ararobo/GN10RemoteEmergencyStop/docs/PowerCutoffBoard_parts.md

# PowerCutoffBoard's parts list
This list is memo.

## K
|KiCad|Name|URL|
|:-:|:-:|:-:|
|K1|FBR562ND12-W|https://docs.rs-online.com/b128/A700000006723828.pdf|

## D
|KiCad|Name|URL|
|:-:|:-:|:-:|
|D3,D4|

## Y
|KiCad|Name|URL|
|:-:|:-:|:-:|
|Y1|CSTNE24M0VH3C000R0|https://www.mouser.jp/ProductDetail/Murata-Electronics/CSTNE24M0VH3C000R0?qs=hd1VzrDQEGgTlQsO5HCwUg%3D%3D|

## Q
|KiCad|Name|URL|
|:-:|:-:|:-:|
|Q1,Q2|SSM3K341R|https://www.mouser.jp/ProductDetail/Toshiba/SSM3K341RLF?qs=PDgMCp4xDJYlECuIdOFceQ%3D%3D|

## U
|KiCad|Name|URL|
|:-:|:-:|:-:|
|U1|STM32G431CBU3|https://www.mouser.jp/ProductDetail/STMicroelectronics/STM32G431CBU3?qs=PzGy0jfpSMuhNWEWgwfZ0w%3D%3D|
|U1|STM32G431CBU6|https://www.mouser.jp/ProductDetail/STMicroelectronics/STM32G431CBU6?qs=T3oQrply3y%252B0hTuSHQ7oqA%3D%3D|
|U2|MIC4427ZM|https://www.mouser.jp/ProductDetail/Microchip-Technology/MIC4427ZM-TR?qs=U6T8BxXiZAXGJd0nLDru8w%3D%3D|
|U3|MCP2562-E/SN|https://www.mouser.jp/ProductDetail/Microchip-Technology/MCP2562-E-SN?qs=6qKXPk0vzx3LlPUMCCw%252BCg%3D%3D|
|U4|Wio-E5|https://www.mouser.jp/ProductDetail/Seeed-Studio/317990687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|
|U5|OSL10326-IR|https://akizukidenshi.com/catalog/g/g112644/|
|U6|TPS1117LV33S|https://akizukidenshi.com/catalog/g/g117229/|

## C
|KiCad|Name|URL|
|:-:|:-:|:-:|
|C19,C20|dia:18, lead:7.5|https://www.mouser.jp/ProductDetail/Nichicon/UHE1H272MHD?qs=MKCO98gu%252BEEMRtwCCrkFNQ%3D%3D|
