ararobo/GN10RemoteEmergencyStop/hardware/PowerCutoffBoard1/PowerCutoffBoard1.kicad_pcb

## KiCad design hardware/PowerCutoffBoard1/PowerCutoffBoard1.kicad_pcb (2025-09-01)

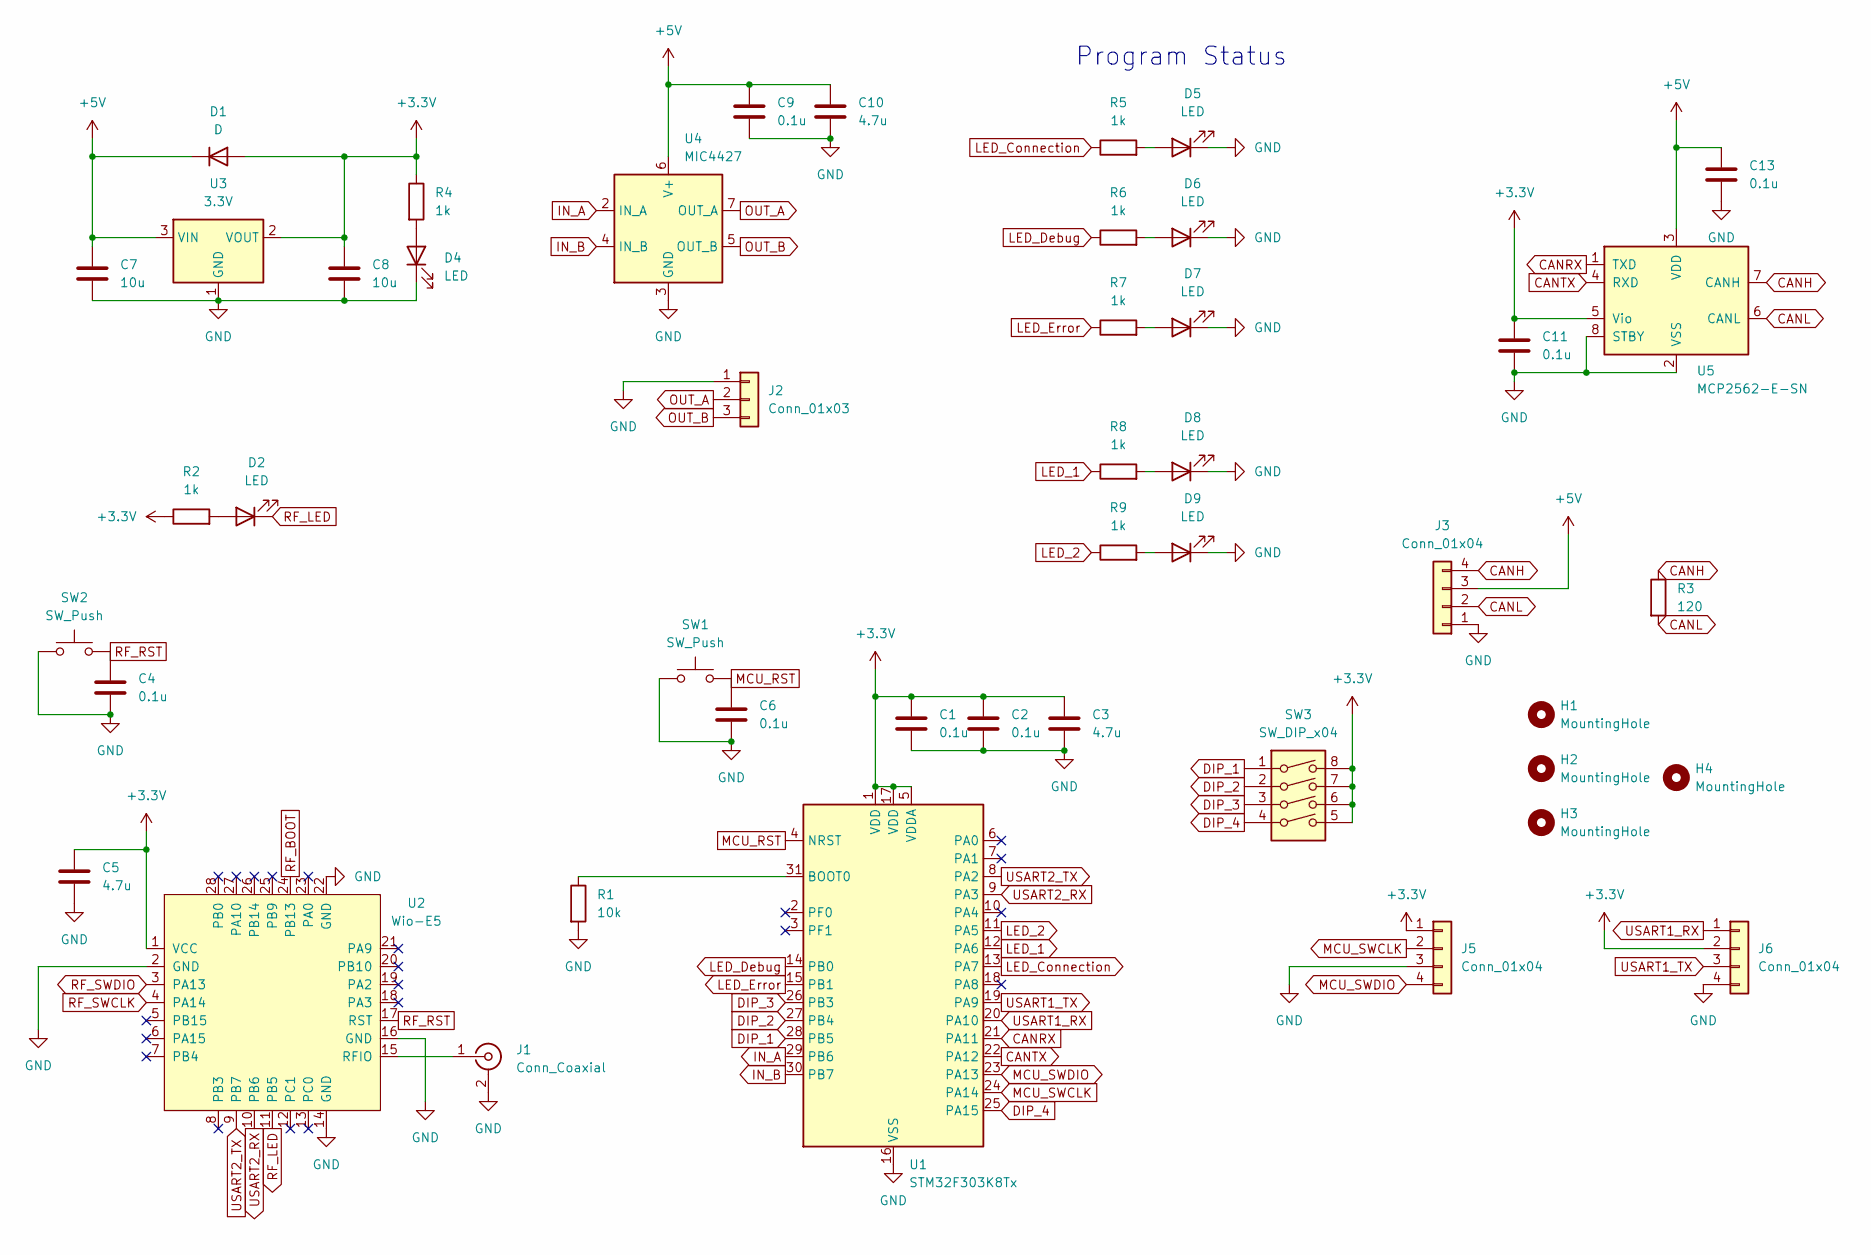
[picture p2: schematic PowerCutoffBoard1.kicad_sch]

Parts:
C1, C2, C4, C6, C9, C11, C13: 0.1u; C_0603_1608Metric_Pad1.08x0.95mm_HandSolder
C3, C5, C10: 4.7u; C_0603_1608Metric_Pad1.08x0.95mm_HandSolder
C7, C8: 10u; C_0603_1608Metric_Pad1.08x0.95mm_HandSolder
D1: D; Nexperia_CFP3_SOD-123W
D2, D4, D5, D6, D7, D8, D9: LED; LED_0603_1608Metric_Pad1.05x0.95mm_HandSolder
H1, H2, H3, H4: MountingHole; MountingHole_3.2mm_M3
J1: Conn_Coaxial; SMA_Molex_73251-2120_EdgeMount_Horizontal
J2: Conn_01x03; AMASS_MR30PW-FB_1x03_P3.50mm_Horizontal
J3: Conn_01x04; JST_XH_S4B-XH-A_1x04_P2.50mm_Horizontal
J5, J6: Conn_01x04; JST_XH_B4B-XH-A_1x04_P2.50mm_Vertical
R1: 10k; C_0603_1608Metric_Pad1.08x0.95mm_HandSolder
R2, R4, R5, R6, R7, R8, R9: 1k; C_0603_1608Metric_Pad1.08x0.95mm_HandSolder
R3: 120; R_0603_1608Metric_Pad0.98x0.95mm_HandSolder
SW1, SW2: SW_Push; TVAF
SW3: SW_DIP_x04; SW_DIP_SPSTx04_Slide_Copal_CHS-04B_W7.62mm_P1.27mm
U1: STM32F303K8Tx; LQFP-32_7x7mm_P0.8mm
U2: Wio-E5; LoRa-E5
U3: 3.3V; SOT-223-3_TabPin2
U4: MIC4427; SOIC-8_3.9x4.9mm_P1.27mm
U5: MCP2562-E-SN; SOIC-8_3.9x4.9mm_P1.27mm

Connections:
+3.3V: C1.1, C2.1, C3.1, C5.1, C8.1, C11.1, D1.2 (A), J5.1, J6.2, R2.1, R4.1, SW3.5, SW3.6, SW3.7, SW3.8, U1.1 (VDD), U1.5 (VDDA), U1.17 (VDD), U2.1 (VCC), U3.2 (VOUT), U5.5 (Vio)
+5V: C7.1, C9.1, C10.1, C13.1, D1.1 (K), J3.3, U3.3 (VIN), U4.6 (V+), U5.3 (VDD)
CANH: J3.4, R3.1, U5.7 (CANH)
CANL: J3.2, R3.2, U5.6 (CANL)
CANRX: U1.21 (PA11), U5.1 (TXD)
CANTX: U1.22 (PA12), U5.4 (RXD)
DIP_1: SW3.1, U1.28 (PB5)
DIP_2: SW3.2, U1.27 (PB4)
DIP_3: SW3.3, U1.26 (PB3)
DIP_4: SW3.4, U1.25 (PA15)
GND: C1.2, C2.2, C3.2, C4.2, C5.2, C6.2, C7.2, C8.2, C9.2, C10.2, C11.2, C13.2, D4.1 (K), D5.1 (K), D6.1 (K), D7.1 (K), D8.1 (K), D9.1 (K), J1.2 (Ext), J2.1, J3.1, J5.3, J6.4, R1.2, SW1.1, SW2.1, U1.16 (VSS), U1.32 (VSS), U2.2 (GND), U2.14 (GND), U2.16 (GND), U2.22 (GND), U3.1 (GND), U4.3 (GND), U5.2 (VSS), U5.8 (STBY)
IN_A: U1.29 (PB6), U4.2 (IN_A)
IN_B: U1.30 (PB7), U4.4 (IN_B)
LED_1: R8.1, U1.12 (PA6)
LED_2: R9.1, U1.11 (PA5)
LED_Connection: R5.1, U1.13 (PA7)
LED_Debug: R6.1, U1.14 (PB0)
LED_Error: R7.1, U1.15 (PB1)
MCU_RST: C6.1, SW1.2, U1.4 (NRST)
MCU_SWCLK: J5.2, U1.24 (PA14)
MCU_SWDIO: J5.4, U1.23 (PA13)
unnamed: D2.2 (A), R2.2
unnamed: D4.2 (A), R4.2
unnamed: D5.2 (A), R5.2
unnamed: D6.2 (A), R6.2
unnamed: D7.2 (A), R7.2
unnamed: D8.2 (A), R8.2
unnamed: D9.2 (A), R9.2
unnamed: J1.1 (In), U2.15 (RFIO)
unnamed: R1.1, U1.31 (BOOT0)
OUT_A: J2.2, U4.7 (OUT_A)
OUT_B: J2.3, U4.5 (OUT_B)
RF_BOOT: U2.24 (PB13~)
RF_LED: D2.1 (K), U2.11 (PB5)
RF_RST: C4.1, SW2.2, U2.17 (RST)
RF_SWCLK: U2.4 (PA14)
RF_SWDIO: U2.3 (PA13)
USART1_RX: J6.1, U1.20 (PA10)
USART1_TX: J6.3, U1.19 (PA9)
USART2_RX: U1.9 (PA3), U2.10 (PB6)
USART2_TX: U1.8 (PA2), U2.9 (PB7)

Notes on the sheet:
Program Status

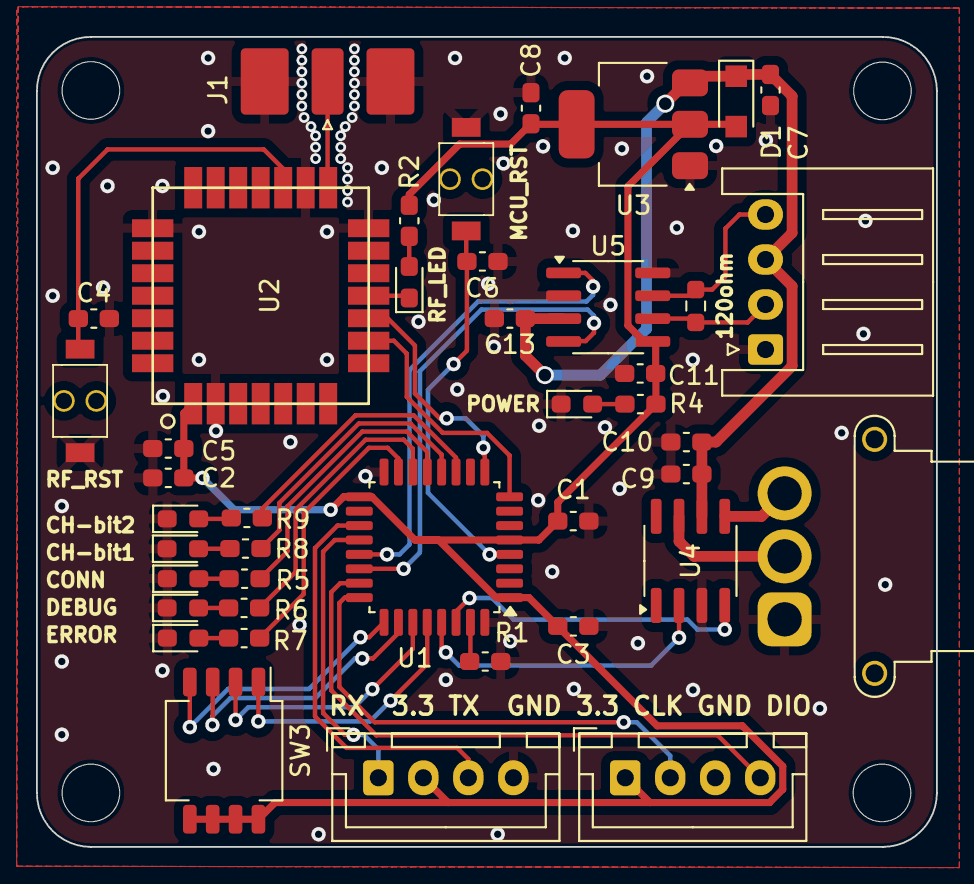
[picture p3: board PowerCutoffBoard1.kicad_pcb from above]

Board: 2 copper layers, 50.0 x 45.0 mm, 46 parts (0 on the bottom side), 38 nets.
