ararobo/GN10RemoteEmergencyStop/hardware/ConsoleBoard/ConsoleBoard.kicad_pcb

## KiCad design hardware/ConsoleBoard/ConsoleBoard.kicad_pcb (2025-08-26)

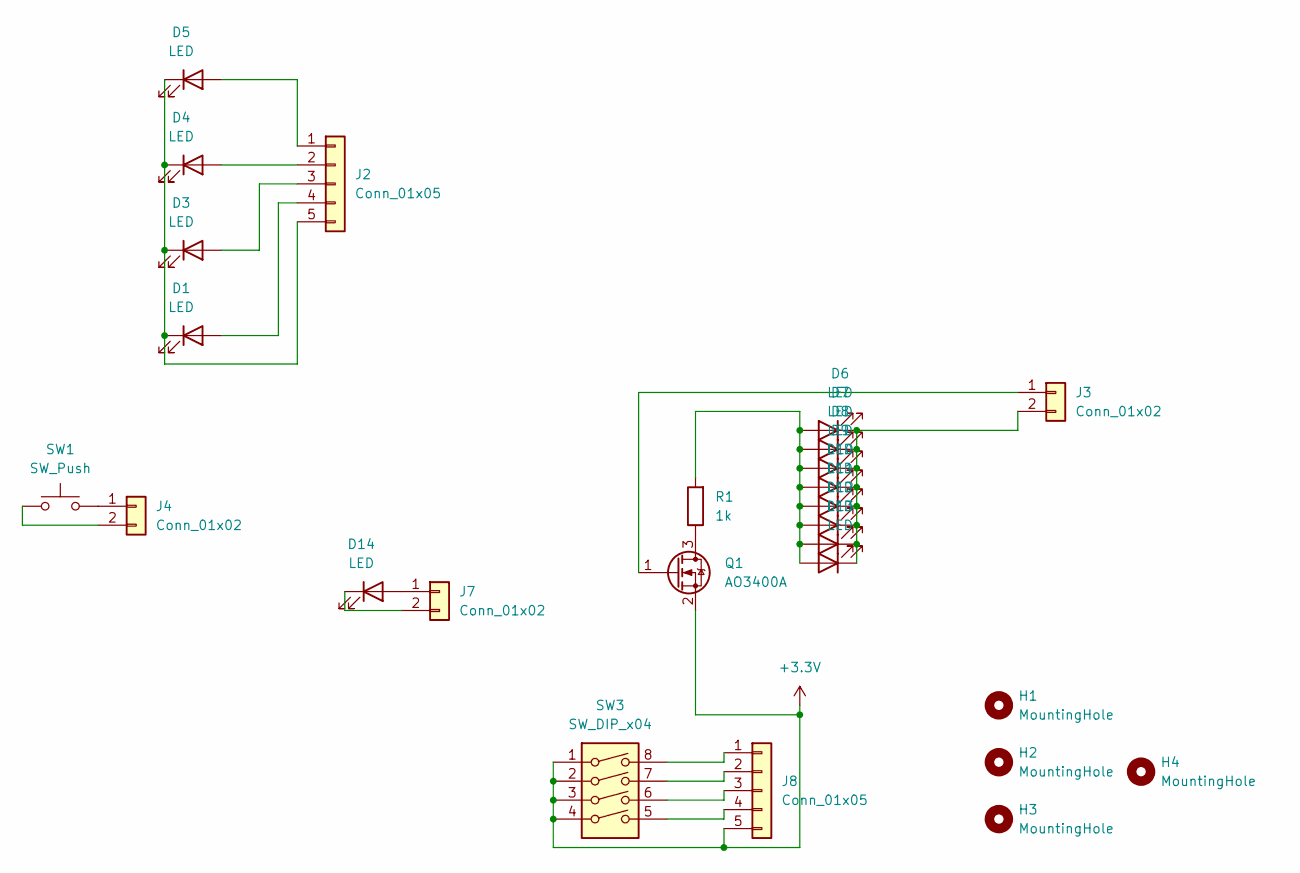
[picture p4: schematic ConsoleBoard.kicad_sch]

Parts:
D1, D3, D4, D5, D6, D7, D8, D9, D10, D11, D12, D13, D14: LED; LED_0603_1608Metric_Pad1.05x0.95mm_HandSolder
H1, H2, H3, H4: MountingHole; MountingHole_3.2mm_M3
J2, J8: Conn_01x05; JST_XH_B5B-XH-AM_1x05_P2.50mm_Vertical
J3, J4, J7: Conn_01x02; JST_XH_B2B-XH-A_1x02_P2.50mm_Vertical
Q1: AO3400A; SOT-23
R1: 1k; C_0603_1608Metric_Pad1.08x0.95mm_HandSolder
SW1: SW_Push; TVAF
SW3: SW_DIP_x04; SW_DIP_SPSTx04_Slide_Copal_CHS-04B_W7.62mm_P1.27mm

Connections:
+3.3V: J8.5, Q1.2 (S), SW3.1, SW3.2, SW3.3, SW3.4
unnamed: D1.2 (A), J2.4
unnamed: D1.1 (K), D3.1 (K), D4.1 (K), D5.1 (K), J2.5
unnamed: D3.2 (A), J2.3
unnamed: D4.2 (A), J2.2
unnamed: D5.2 (A), J2.1
unnamed: D6.2 (A), D7.2 (A), D8.2 (A), D9.2 (A), D10.2 (A), D11.2 (A), D12.2 (A), D13.2 (A), R1.2
unnamed: D6.1 (K), D7.1 (K), D8.1 (K), D9.1 (K), D10.1 (K), D11.1 (K), D12.1 (K), D13.1 (K), J3.2
unnamed: D14.2 (A), J7.1
unnamed: D14.1 (K), J7.2
unnamed: J3.1, Q1.1 (G)
unnamed: J4.1, SW1.2
unnamed: J4.2, SW1.1
unnamed: J8.1, SW3.8
unnamed: J8.2, SW3.7
unnamed: J8.3, SW3.6
unnamed: J8.4, SW3.5
unnamed: Q1.3 (D), R1.1

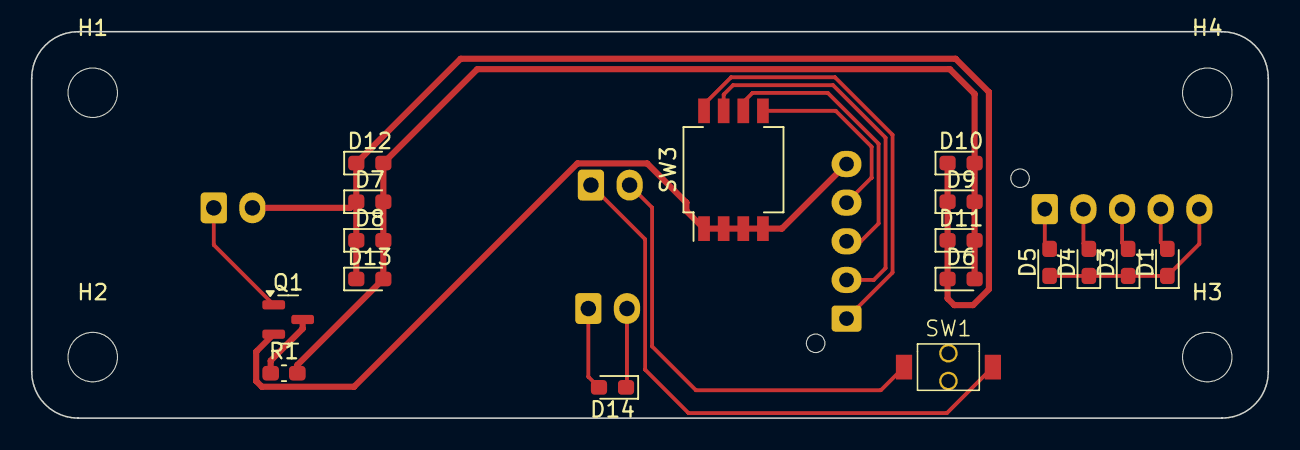
[picture p5: board ConsoleBoard.kicad_pcb from above]

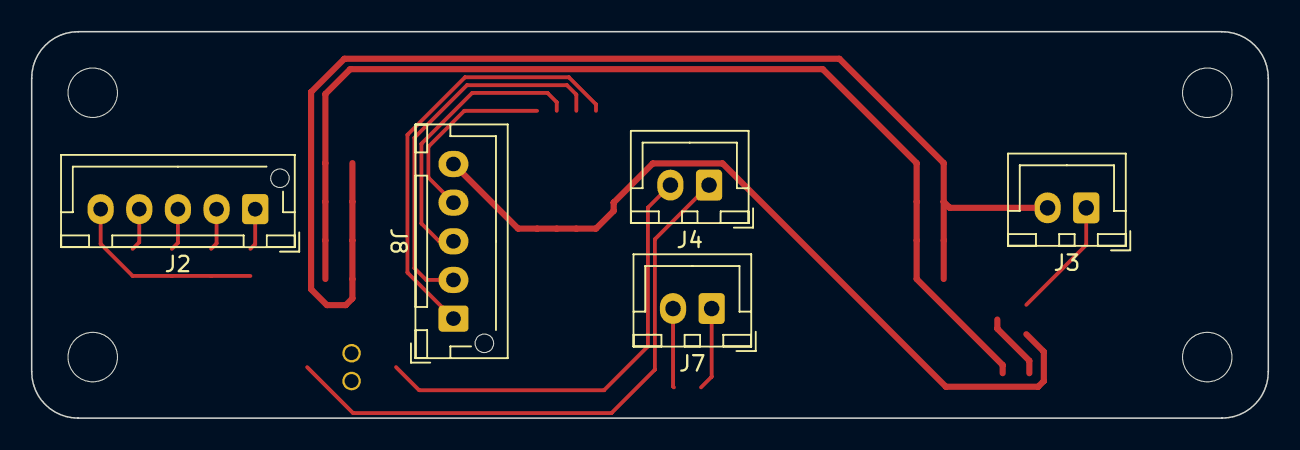
[picture p6: board ConsoleBoard.kicad_pcb from below]

Board: 2 copper layers, 80.0 x 25.0 mm, 26 parts (5 on the bottom side), 18 nets.
