ararobo/GN10RemoteEmergencyStop/hardware/PowerCutoffBoard2/PowerCutoffBoard2.kicad_pcb

## KiCad design hardware/PowerCutoffBoard2/PowerCutoffBoard2.kicad_pcb (2025-08-13)

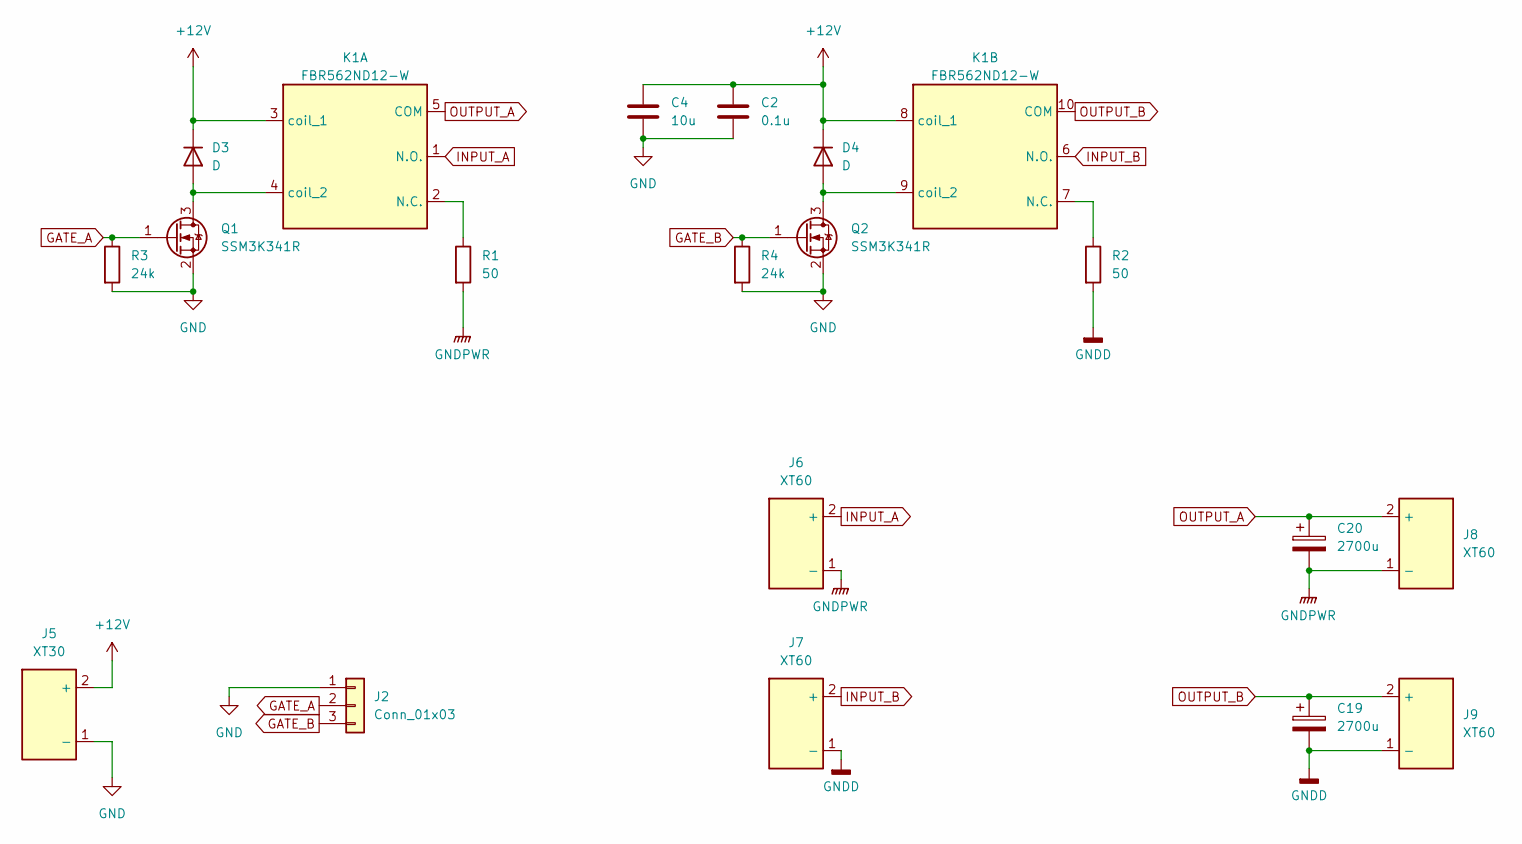
[picture p7: schematic PowerCutoffBoard2.kicad_sch, GN10PowerCutoffBoard]

Parts:
C2: 0.1u; C_0603_1608Metric_Pad1.08x0.95mm_HandSolder
C4: 10u; C_0805_2012Metric_Pad1.18x1.45mm_HandSolder
C19, C20: 2700u; CP_Radial_D18.0mm_P7.50mm
D3, D4: D; D_SMA_Handsoldering
J2: Conn_01x03; AMASS_MR30PW-M_1x03_P3.50mm_Horizontal
J5: XT30; AMASS_XT30PW-M_1x02_P2.50mm_Horizontal
J6, J7: XT60; AMASS_XT60-M_1x02_P7.20mm_Vertical
J8, J9: XT60; AMASS_XT60-F_1x02_P7.20mm_Vertical
K1: FBR562ND12-W; FBR562
Q1, Q2: SSM3K341R; SOT-23
R1, R2: 50; R_2010_5025Metric_Pad1.40x2.65mm_HandSolder
R3, R4: 24k; R_0603_1608Metric_Pad0.98x0.95mm_HandSolder

Connections:
+12V: C2.1, C4.1, D3.1 (K), D4.1 (K), J5.2 (+), K1.3 (coil_1), K1.8 (coil_1)
GATE_A: J2.2, Q1.1 (G), R3.1
GATE_B: J2.3, Q2.1 (G), R4.1
GND: C2.2, C4.2, J2.1, J5.1 (-), Q1.2 (S), Q2.2 (S), R3.2, R4.2
GNDD: C19.2, J7.1 (-), J9.1 (-), R2.2
GNDPWR: C20.2, J6.1 (-), J8.1 (-), R1.2
INPUT_A: J6.2 (+), K1.1 (N.O.)
INPUT_B: J7.2 (+), K1.6 (N.O.)
unnamed: D3.2 (A), K1.4 (coil_2), Q1.3 (D)
unnamed: D4.2 (A), K1.9 (coil_2), Q2.3 (D)
unnamed: K1.2 (N.C.), R1.1
unnamed: K1.7 (N.C.), R2.1
OUTPUT_A: C20.1, J8.2 (+), K1.5 (COM)
OUTPUT_B: C19.1, J9.2 (+), K1.10 (COM)

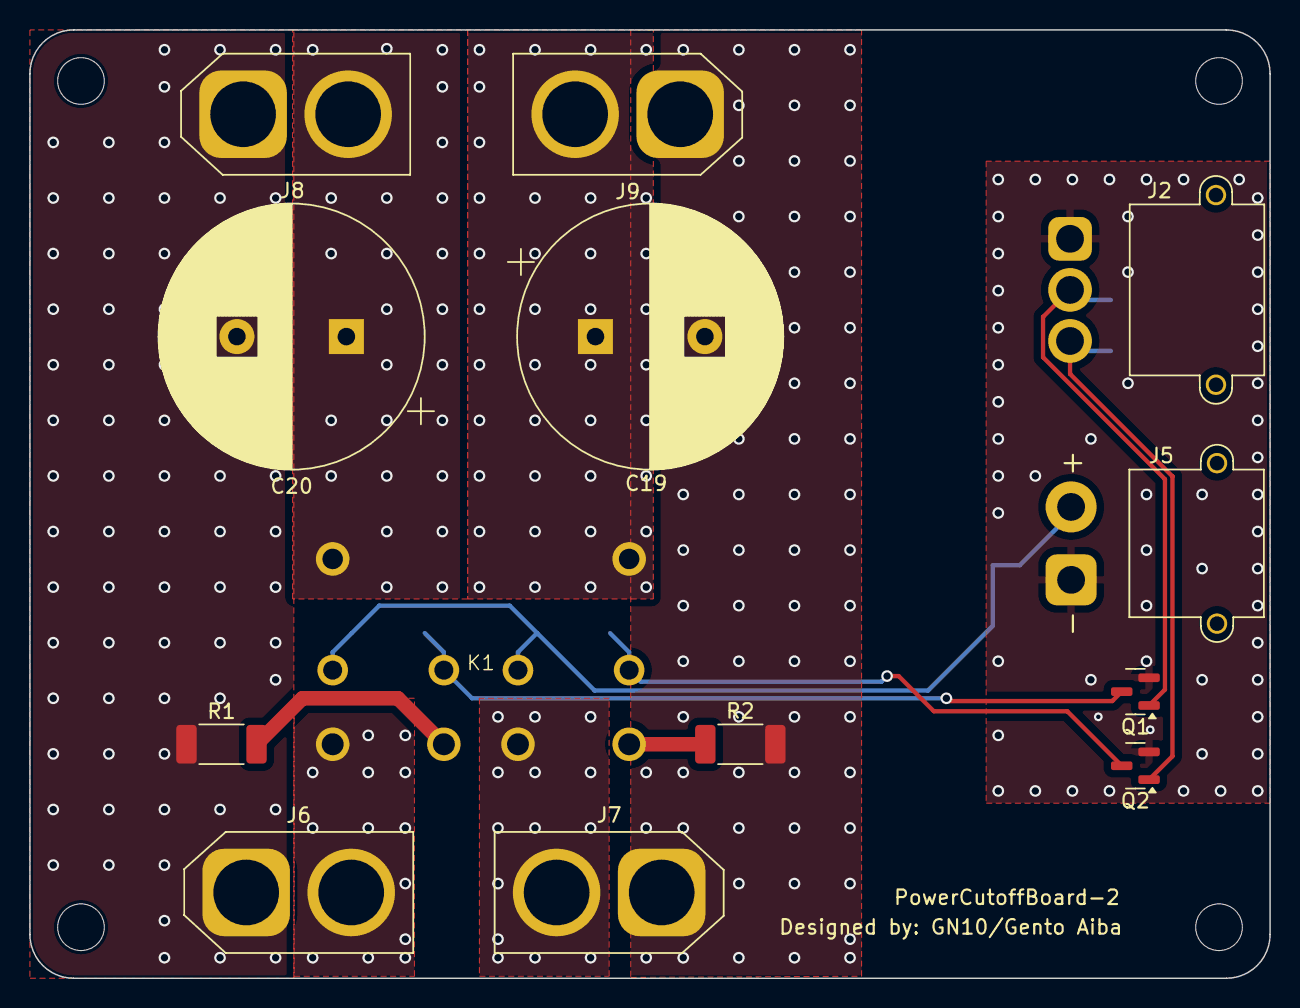
[picture p8: board PowerCutoffBoard2.kicad_pcb from above]

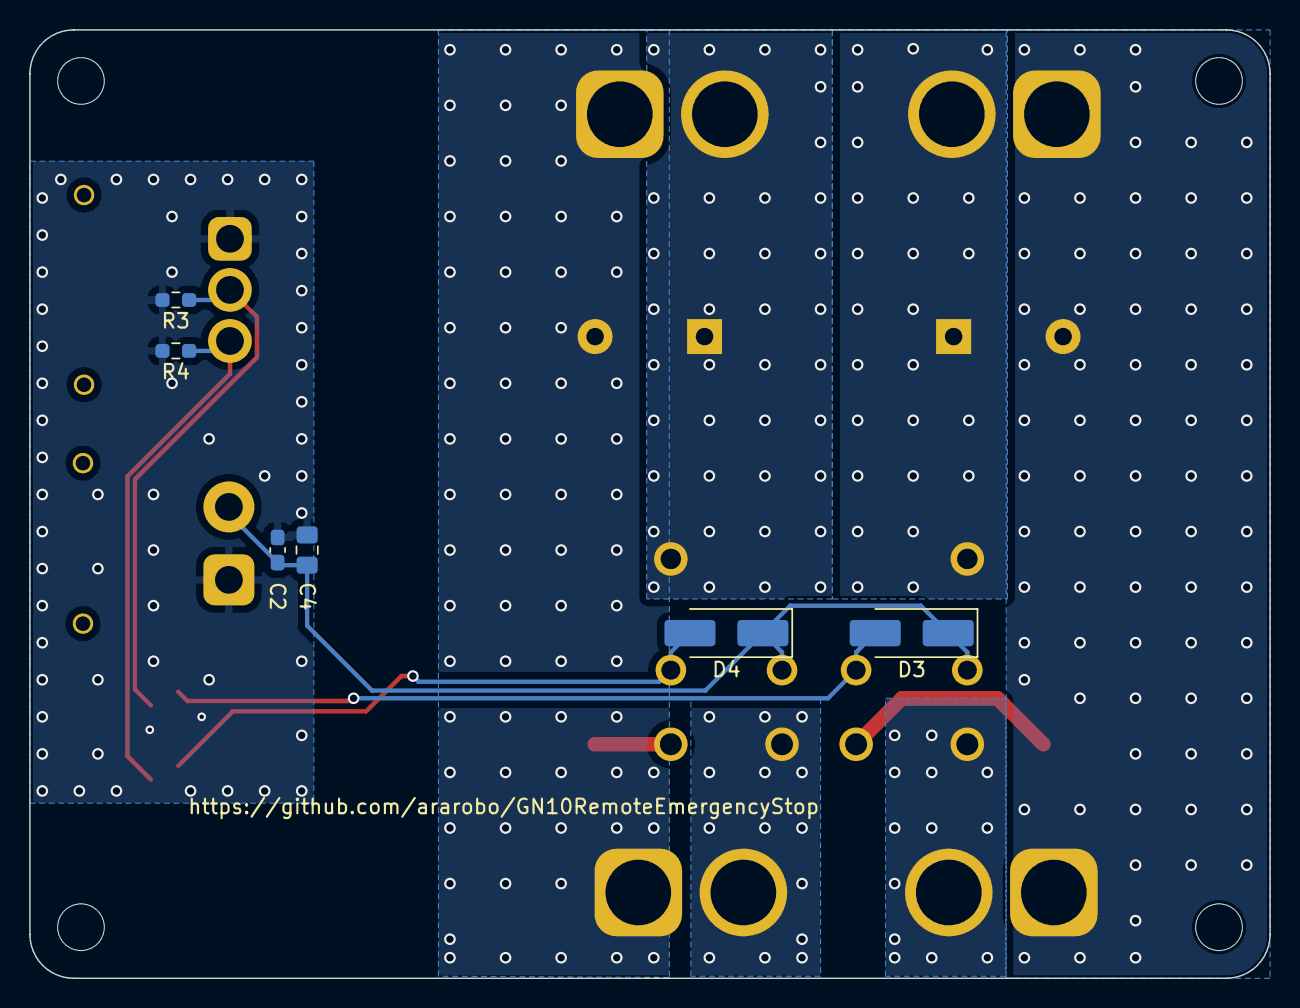
[picture p9: board PowerCutoffBoard2.kicad_pcb from below]

Board: 2 copper layers, 85.0 x 65.0 mm, 19 parts (6 on the bottom side), 14 nets.
