ararobo/GN10RemoteEmergencyStop/firmware/PowerCuttoffBoard/Core/Src/main.cpp

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
/* Includes ------------------------------------------------------------------*/
#include "main.h"
#include "can.h"
#include "usart.h"
#include "gpio.h"

/* USER CODE BEGIN Includes */
#include "app.hpp"
/* USER CODE END Includes */


void SystemClock_Config(void);
/* USER CODE BEGIN 0 */
App app;
WioE5 wioE5;
/* USER CODE END 0 */

/**
 * @brief  The application entry point.
 * @retval int
 */
int main(void)
{

  /* MCU Configuration--------------------------------------------------------*/

  /* Reset of all peripherals, Initializes the Flash interface and the Systick. */
  HAL_Init();

  /* Configure the system clock */
  SystemClock_Config();

  /* Initialize all configured peripherals */
  MX_GPIO_Init();
  MX_CAN_Init();
  MX_USART1_UART_Init();
  MX_USART2_UART_Init();
  /* USER CODE BEGIN 2 */
  HAL_GPIO_WritePin(GPIOB, RELAY_A_Pin, GPIO_PIN_SET);
  HAL_GPIO_WritePin(GPIOB, RELAY_B_Pin, GPIO_PIN_SET);
  HAL_GPIO_WritePin(GPIOA, LED1_Pin, GPIO_PIN_RESET);
  HAL_Delay(1000);
  wioE5.setup();
  HAL_Delay(1000);
  app.setup();
  /* USER CODE END 2 */

  /* Infinite loop */
  /* USER CODE BEGIN WHILE */
  while (1)
  {
    /* USER CODE END WHILE */

    /* USER CODE BEGIN 3 */
    wioE5.loop();
    app.loop();
  }
  /* USER CODE END 3 */
}

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
