ararobo/GN10RemoteEmergencyStop/(commit log)

2024-09-25 プロジェクト作成
    [power_cutoff_unit.kicad_pcb, power_cutoff_unit.kicad_sch, remote_emergency_stop.kicad_pcb, remote_emergency_stop.kicad_sch]
2024-10-01 通信モジュール決定
    [remote_emergency_stop.kicad_pcb, remote_emergency_stop.kicad_sch]
2024-10-03 こりゃだめだ、ユーザーインタフェイスが整ってない。
    [remote_emergency_stop.kicad_pcb, remote_emergency_stop.kicad_sch]
2024-10-03 遠隔非常停止は回路だけ完成した気がする
    [remote_emergency_stop.kicad_pcb, remote_emergency_stop.kicad_sch]
2024-10-03 ESP32とIOをすこしまとめた
    [remote_emergency_stop.kicad_sch]
2024-10-05 遠隔非常停止のフットプリント決定した。回路にコンデンサ追加
    [remote_emergency_stop.kicad_pcb, remote_emergency_stop.kicad_sch]
2024-10-05 駆動系電源社団モジュールの回路設計開始。リレーのシンボル作成。STM32も選定。
    [power_cutoff_unit.kicad_sch]
2024-10-07 駆動系側の電圧変換ICを追加した
    [power_cutoff_unit.kicad_sch]
2024-10-09 難しくてわかんないッピ
    [power_cutoff_unit.kicad_sch, remote_emergency_stop.kicad_sch]
2024-10-14 細かい部品追加した。
    [power_cutoff_unit.kicad_sch]
2024-10-14 5Vを選択的にした
    [power_cutoff_unit.kicad_sch]
2024-10-14 CubeMXでプロジェクト作成
    [power_cutoff_unit.kicad_sch]
2024-10-14 MOSFET修正とCの値入れた。
    [power_cutoff_unit.kicad_sch]
2024-10-19 STM32のピン配置とインジケーターを追加
    [power_cutoff_unit.kicad_sch, remote_emergency_stop.kicad_sch]
2024-10-19 ピン名等見直し
    [power_cutoff_unit.kicad_sch]
2024-10-19 パスコン追加、電源追加(修正)
    [power_cutoff_unit.kicad_sch]
2024-10-19 3.3Vをスイッチングレギュレータにして、5Vの電源生成を消した。
    [power_cutoff_unit.kicad_sch]
2024-10-19 リレー増築中
    [power_cutoff_unit.kicad_sch]
2024-10-20 リレー3個にしてゲートドライバも追加
    [power_cutoff_unit.kicad_sch]
2024-10-20 DLC通るようにした
    [power_cutoff_unit.kicad_sch]
2024-10-20 日付変更
    [power_cutoff_unit.kicad_sch]
2024-10-20 配置考え直す。
    [power_cutoff_unit.kicad_pcb, power_cutoff_unit.kicad_sch]
2024-10-21 何したか覚えてないけど。
    [power_cutoff_unit.kicad_pcb, power_cutoff_unit.kicad_sch]
2024-10-22 電圧書いた。配置きれいにした。
    [power_cutoff_unit.kicad_sch]
2024-10-22 PCBに入ったけどコンデンサの放電用抵抗を小さくしたい。
    [power_cutoff_unit.kicad_pcb, power_cutoff_unit.kicad_sch]
2024-10-24 配置考え始めた
    [power_cutoff_unit.kicad_pcb, power_cutoff_unit.kicad_sch]
2024-10-28 PCBの配置考え中
    [power_cutoff_unit.kicad_pcb, power_cutoff_unit.kicad_sch]
2024-10-28 大電流部品の主な配置を考えた。
    [power_cutoff_unit.kicad_pcb]
2024-10-29 重要な制御系部品の配置を少し考えた。
    [power_cutoff_unit.kicad_pcb]
2024-11-01 高額だし、大きいので5Vラインのスイッチングレギュレーターを変更。
    [power_cutoff_unit.kicad_pcb, power_cutoff_unit.kicad_sch]
2024-11-03 現時点を記録
    [A6FR_3101.step, A6FR_4101.step, CJS-1200B1.stp, CZ3A07.stp, DS04-254-2-04BK-SMT.stp, ESP32-C3-WROOM-02-N4.stp, FR01FR16H-S.stp, FT2232HQ-TRAY.step]
2024-11-03 電源遮断ユニット：ファームをiocだけにして、kicadのプロジェクトを新規作成。
    [A6FR_3101.step, A6FR_4101.step, CJS-1200B1.stp, CZ3A07.stp, DS04-254-2-04BK-SMT.stp, ESP32-C3-WROOM-02-N4.stp, FR01FR16H-S.stp, FT2232HQ-TRAY.step]
2024-11-04 仕様部品を記載しREADMEを更新
    [power_cutoff_unit.kicad_sch]
2024-11-04 部品表更新
2024-11-07 集積回路だけ追加
    [power_cutoff_unit.kicad_sch]
2024-11-07 必要そうなシンボルとフットプリント追加
    [power_cutoff_unit.kicad_sch]
2024-11-10 自動生成されるバックアップ用のzipを消去。
2024-11-19 電源回りの回路をいい加減に作った。
    [power_cutoff_unit.kicad_sch]
2024-11-20 仕様書追記。リレーの追加。
    [power_cutoff_unit.kicad_sch]
2024-11-20 gitignoreのパスがバックスラッシュになっていたので修正
2024-11-21 リレーの回路を組み立てた。
    [power_cutoff_unit.kicad_sch]
2024-12-17 Good bye ESP32 !!!!!!!
    [power_cutoff_unit.kicad_sch]
2024-12-19 add: RNBD451
    [power_cutoff_unit.kicad_sch]
2024-12-20 RNBD451のFPを作ってる。
    [power_cutoff_unit.kicad_sch]
2024-12-22 RNBD451のフットプリント完成。
2024-12-29 少しだけ配線した。
    [power_cutoff_unit.kicad_sch]
2025-02-04 add: Wio-5E
    [power_cutoff_unit.kicad_pcb, power_cutoff_unit.kicad_sch]
2025-02-16 revised: all
    [PowerCutoffBoard.kicad_pcb, PowerCutoffBoard.kicad_sch, RemoteSwitchBoard.kicad_pcb, RemoteSwitchBoard.kicad_sch, power_cutoff_unit.kicad_pcb, power_cutoff_unit.kicad_sch, remote_emergency_stop.kicad_pcb, remote_emergency_stop.kicad_sch]
2025-02-18 update: PowerCutoffBoard's schematic.
    [PowerCutoffBoard.kicad_sch]
2025-02-19 add: parts list. update: schematic.
    [PowerCutoffBoard.kicad_pcb, PowerCutoffBoard.kicad_sch]
2025-04-02 generate: gaber PowerCutoffBoard2
    [PowerCutoffBoard2.kicad_pcb, RemoteSwitchBoard.kicad_pcb, RemoteSwitchBoard.kicad_sch]
2025-05-02 PCB:Temporarily correct placement of parts
    [PowerCutoffBoard1.kicad_pcb]
2025-05-03 update:PCB updated
    [PowerCutoffBoard1.kicad_pcb]
2025-08-07 Wired PowerCutoffBoard1
    [PowerCutoffBoard1.kicad_pcb, PowerCutoffBoard1.kicad_sch]
2025-08-09 RemoteSwitchBoard sch
    [PowerCutoffBoard1.kicad_pcb, RemoteSwitchBoard.kicad_sch]
2025-08-30 update:配置の変更,配線の改善
    [RemoteSwitchBoard.kicad_pcb, RemoteSwitchBoard.kicad_sch]
2025-09-01 update:取捨選択とノイズ対策
    [PowerCutoffBoard1.kicad_pcb, PowerCutoffBoard1.kicad_sch]
2025-09-15 add:relay pin
